masteravinashdubey/2022-BallBot/50_Banti_Pai_Robot-Swarit-updates/Resources/new_assembly (v10~recovered).png

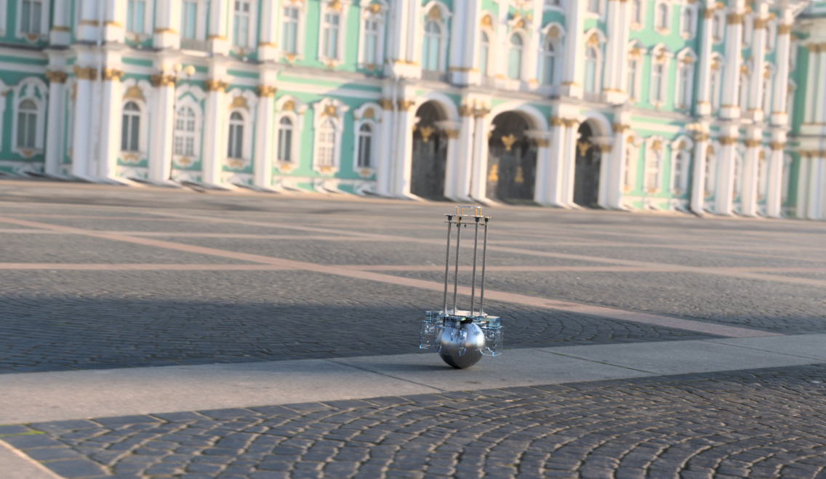
50_Banti_Pai_Robot-Swarit-updates/Resources/new_assembly (v10~recovered).png
