masteravinashdubey/2022-BallBot/README.md

<a href="https://www.youtube.com/watch?v=X55rTUPi5_A&list=PLK0jpMYIBd6BGnQJQYf43Kv_qziwwk5SU&index=11"># 50_Banti_Pai_Robot</a>
