masteravinashdubey/2022-BallBot/50_Banti_Pai_Robot-Swarit-updates/Resources/banti_pai label2.jpg

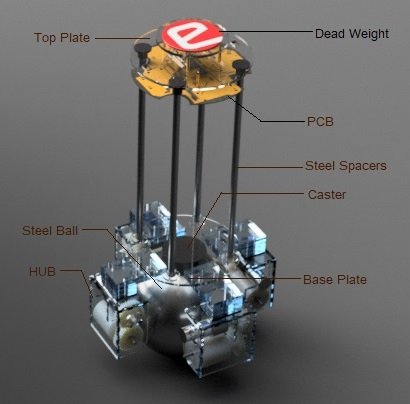
50_Banti_Pai_Robot-Swarit-updates/Resources/banti_pai label2.jpg
