masteravinashdubey/2022-BallBot/50_Banti_Pai_Robot-Swarit-updates/Resources/banti_pai label4.jpg

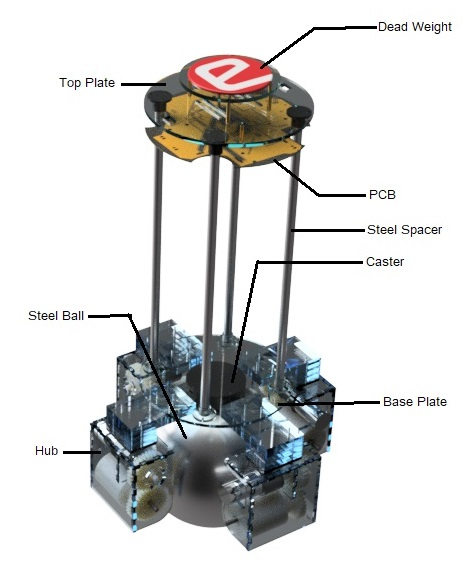
50_Banti_Pai_Robot-Swarit-updates/Resources/banti_pai label4.jpg
