masteravinashdubey/2022-BallBot/50_Banti_Pai_Robot-Swarit-updates/Resources/banti_pai_cad.JPG

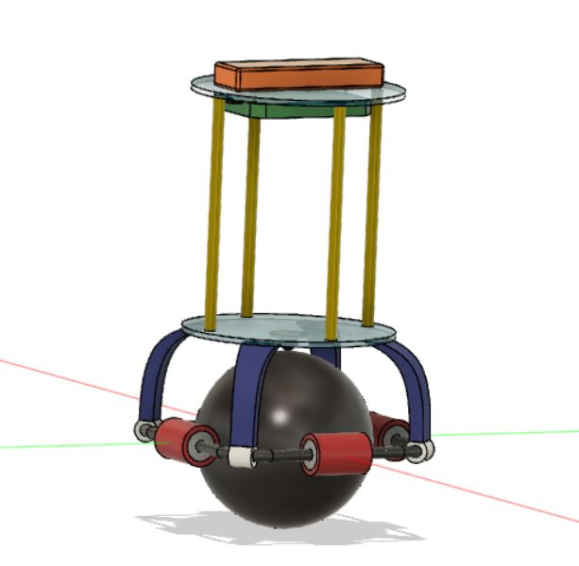
50_Banti_Pai_Robot-Swarit-updates/Resources/banti_pai_cad.JPG
