masteravinashdubey/2022-BallBot/50_Banti_Pai_Robot-Swarit-updates/Resources/Capture.JPG

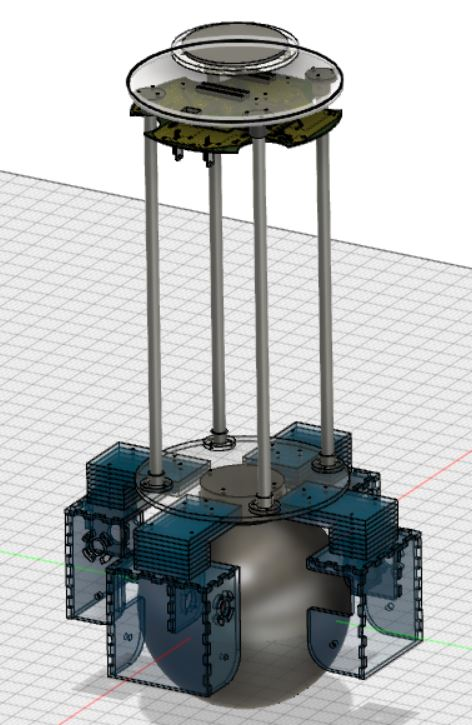
50_Banti_Pai_Robot-Swarit-updates/Resources/Capture.JPG
