masteravinashdubey/2022-BallBot/50_Banti_Pai_Robot-Swarit-updates/Resources/hub2.JPG

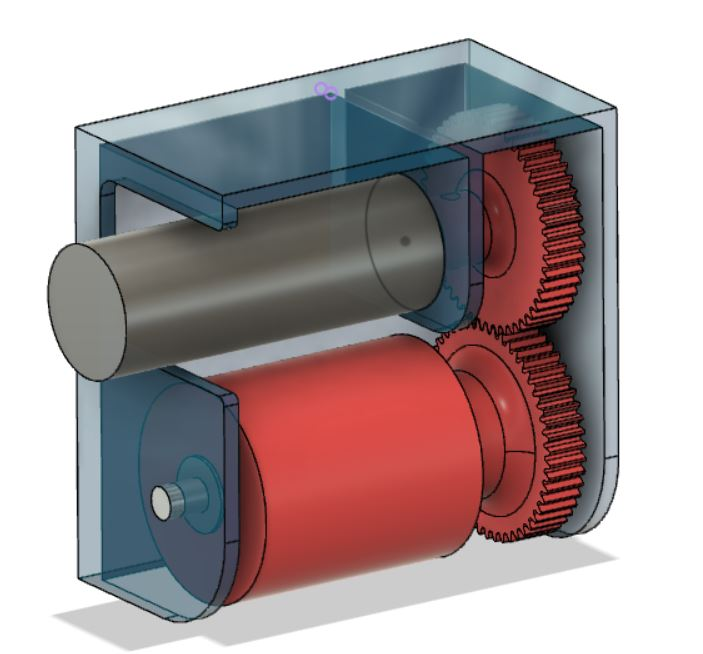
50_Banti_Pai_Robot-Swarit-updates/Resources/hub2.JPG
