masteravinashdubey/2022-BallBot/50_Banti_Pai_Robot-Swarit-updates/Resources/just_bot.png

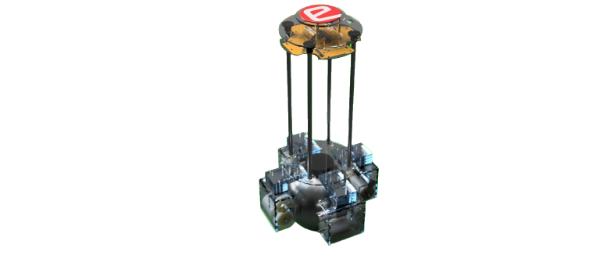
50_Banti_Pai_Robot-Swarit-updates/Resources/just_bot.png
