masteravinashdubey/2022-BallBot/50_Banti_Pai_Robot-Swarit-updates/Resources/render_impro.png

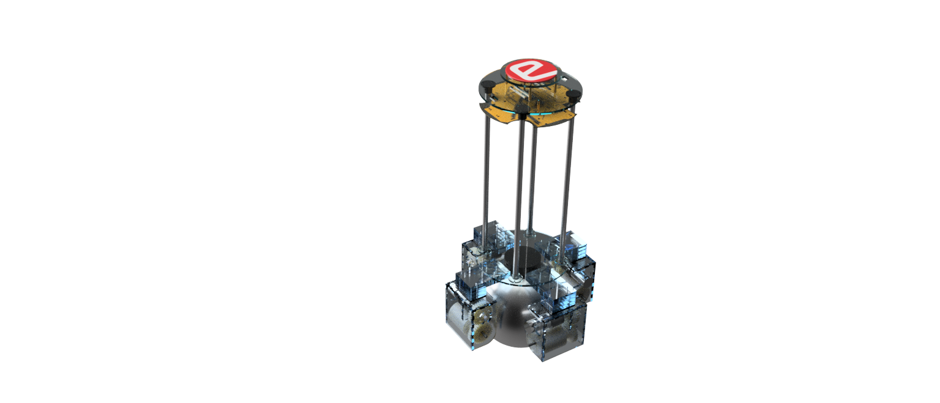
50_Banti_Pai_Robot-Swarit-updates/Resources/render_impro.png
