masteravinashdubey/2022-BallBot/50_Banti_Pai_Robot-Swarit-updates/Resources/components/caster_base.JPG

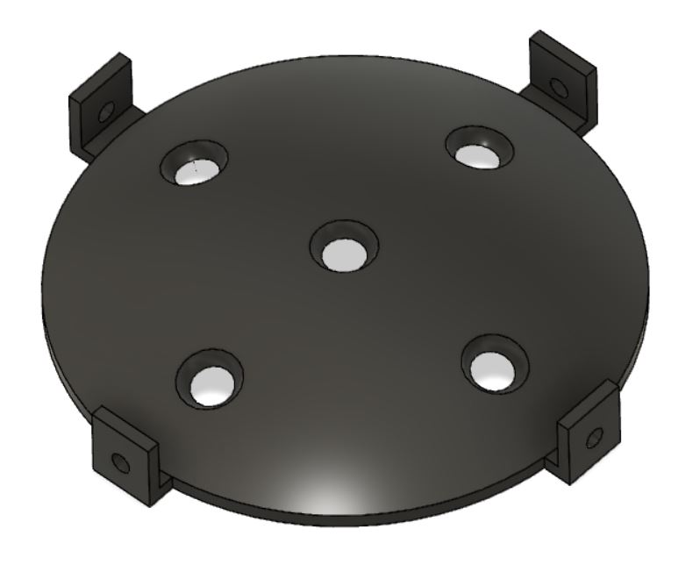
50_Banti_Pai_Robot-Swarit-updates/Resources/components/caster_base.JPG
