masteravinashdubey/2022-BallBot/50_Banti_Pai_Robot-Swarit-updates/Resources/components/caster_top.JPG

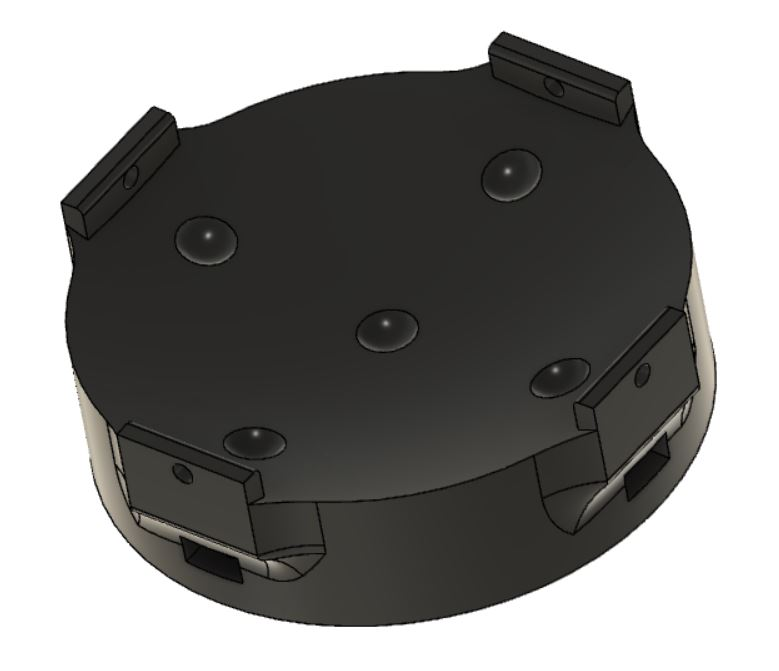
50_Banti_Pai_Robot-Swarit-updates/Resources/components/caster_top.JPG
