masteravinashdubey/2022-BallBot/50_Banti_Pai_Robot-Swarit-updates/Resources/components/flange_holder.JPG

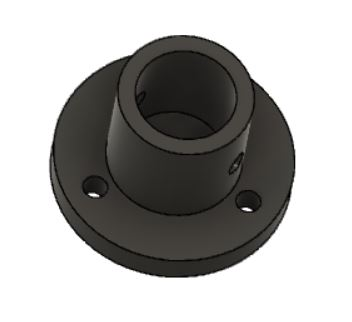
50_Banti_Pai_Robot-Swarit-updates/Resources/components/flange_holder.JPG
