masteravinashdubey/2022-BallBot/50_Banti_Pai_Robot-Swarit-updates/Resources/components/roller.JPG

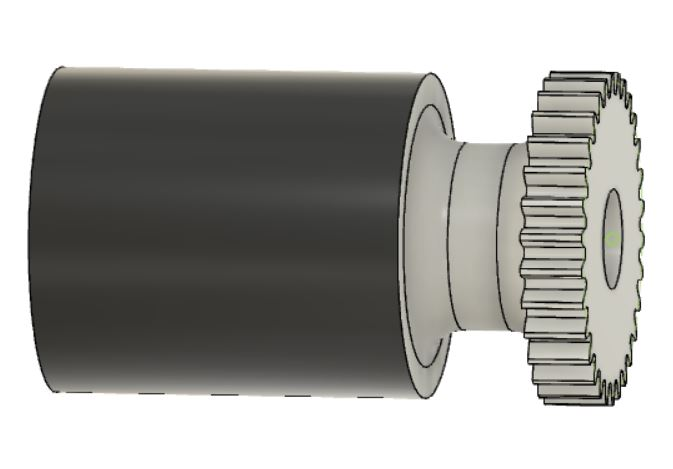
50_Banti_Pai_Robot-Swarit-updates/Resources/components/roller.JPG
