masteravinashdubey/2022-BallBot/50_Banti_Pai_Robot-Swarit-updates/Resources/components/spur_gear.JPG

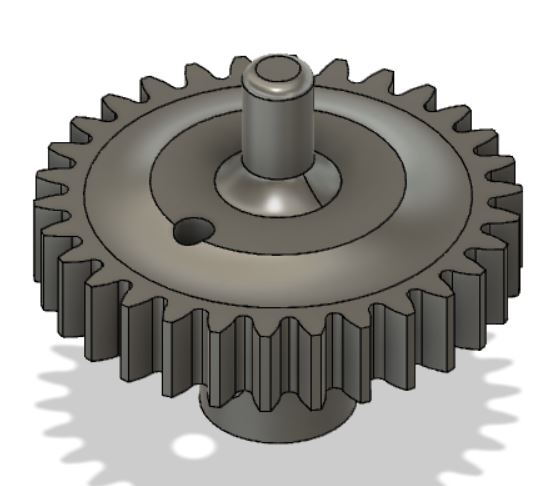
50_Banti_Pai_Robot-Swarit-updates/Resources/components/spur_gear.JPG
