masteravinashdubey/2022-BallBot/50_Banti_Pai_Robot-Swarit-updates/CAD/gcode+stl files/spur_finalllllllll.stl

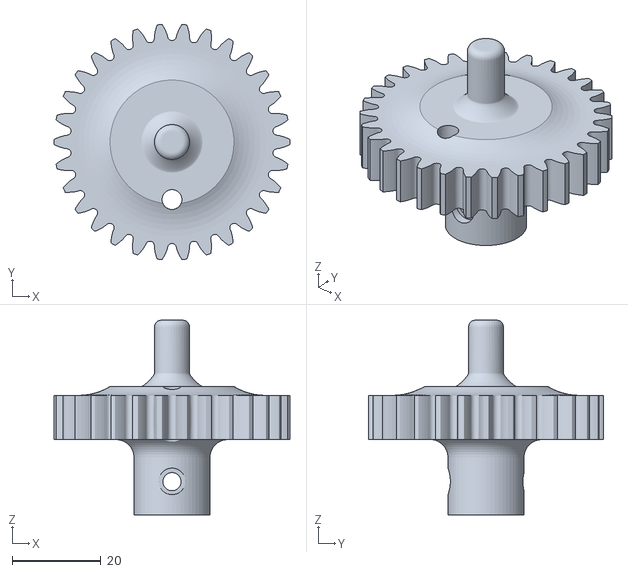
[picture p39: CAD file, 2023-12-04]
50_Banti_Pai_Robot-Swarit-updates/CAD/gcode+stl files/spur_finalllllllll.stl
53.3 x 53.1 x 44.0
