masteravinashdubey/2022-BallBot/50_Banti_Pai_Robot-Swarit-updates/CAD/gcode+stl files/roller_finallllll.stl

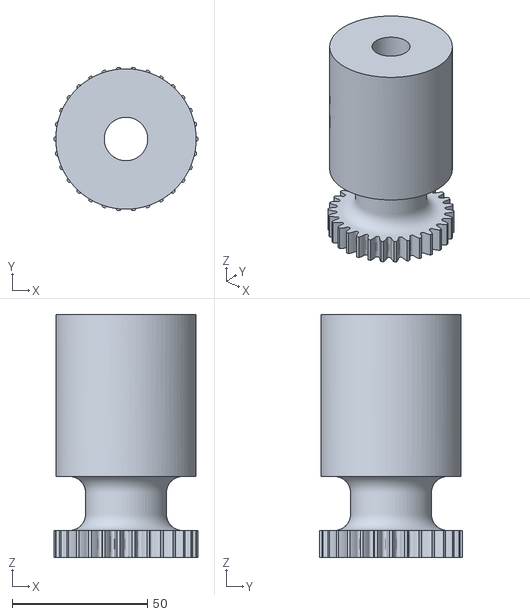
[picture p40: CAD file, 2023-12-04]
50_Banti_Pai_Robot-Swarit-updates/CAD/gcode+stl files/roller_finallllll.stl
53.3 x 53.1 x 90.0
