masteravinashdubey/2022-BallBot/(list of files, cad)

Other CAD files:
50_Banti_Pai_Robot-Swarit-updates/CAD/shaft/shaft.f3d
