masteravinashdubey/2022-BallBot/50_Banti_Pai_Robot-Swarit-updates/CAD/spur_gear_v3 Drawing v1.pdf

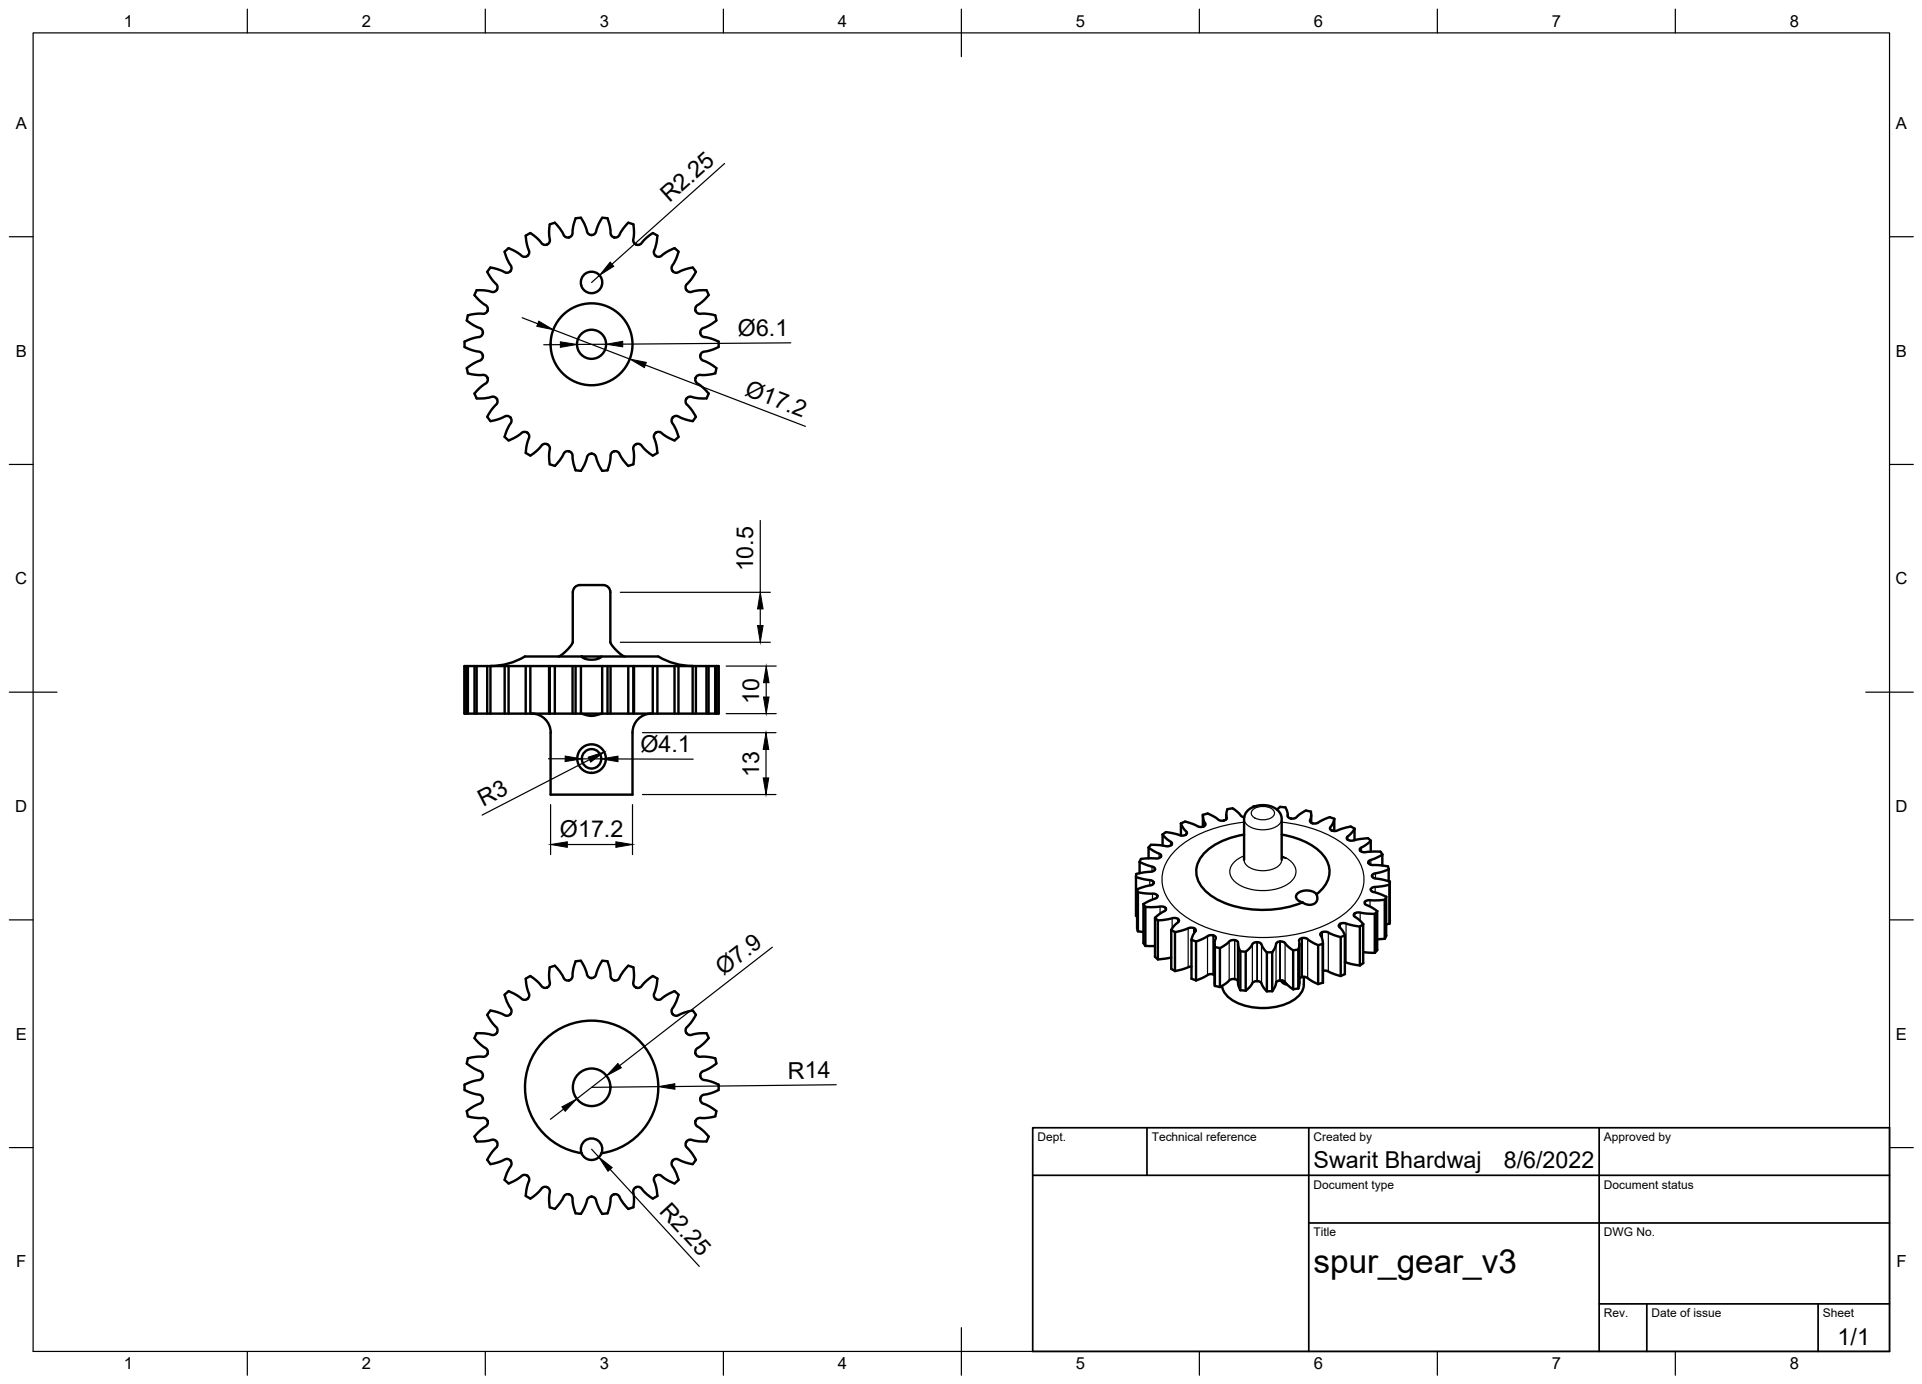
[picture p42: page 1]
Title; DWG No.; Rev.; Date of issue; Sheet; Swarit Bhardwaj 10.5 10

Dept. | Technical reference | Created by 8/6/2022 | Approved by

Document type | Document status
