masteravinashdubey/2022-BallBot/50_Banti_Pai_Robot-Swarit-updates/CAD/shaft/FLANGE_HOLDER Drawing v1.pdf

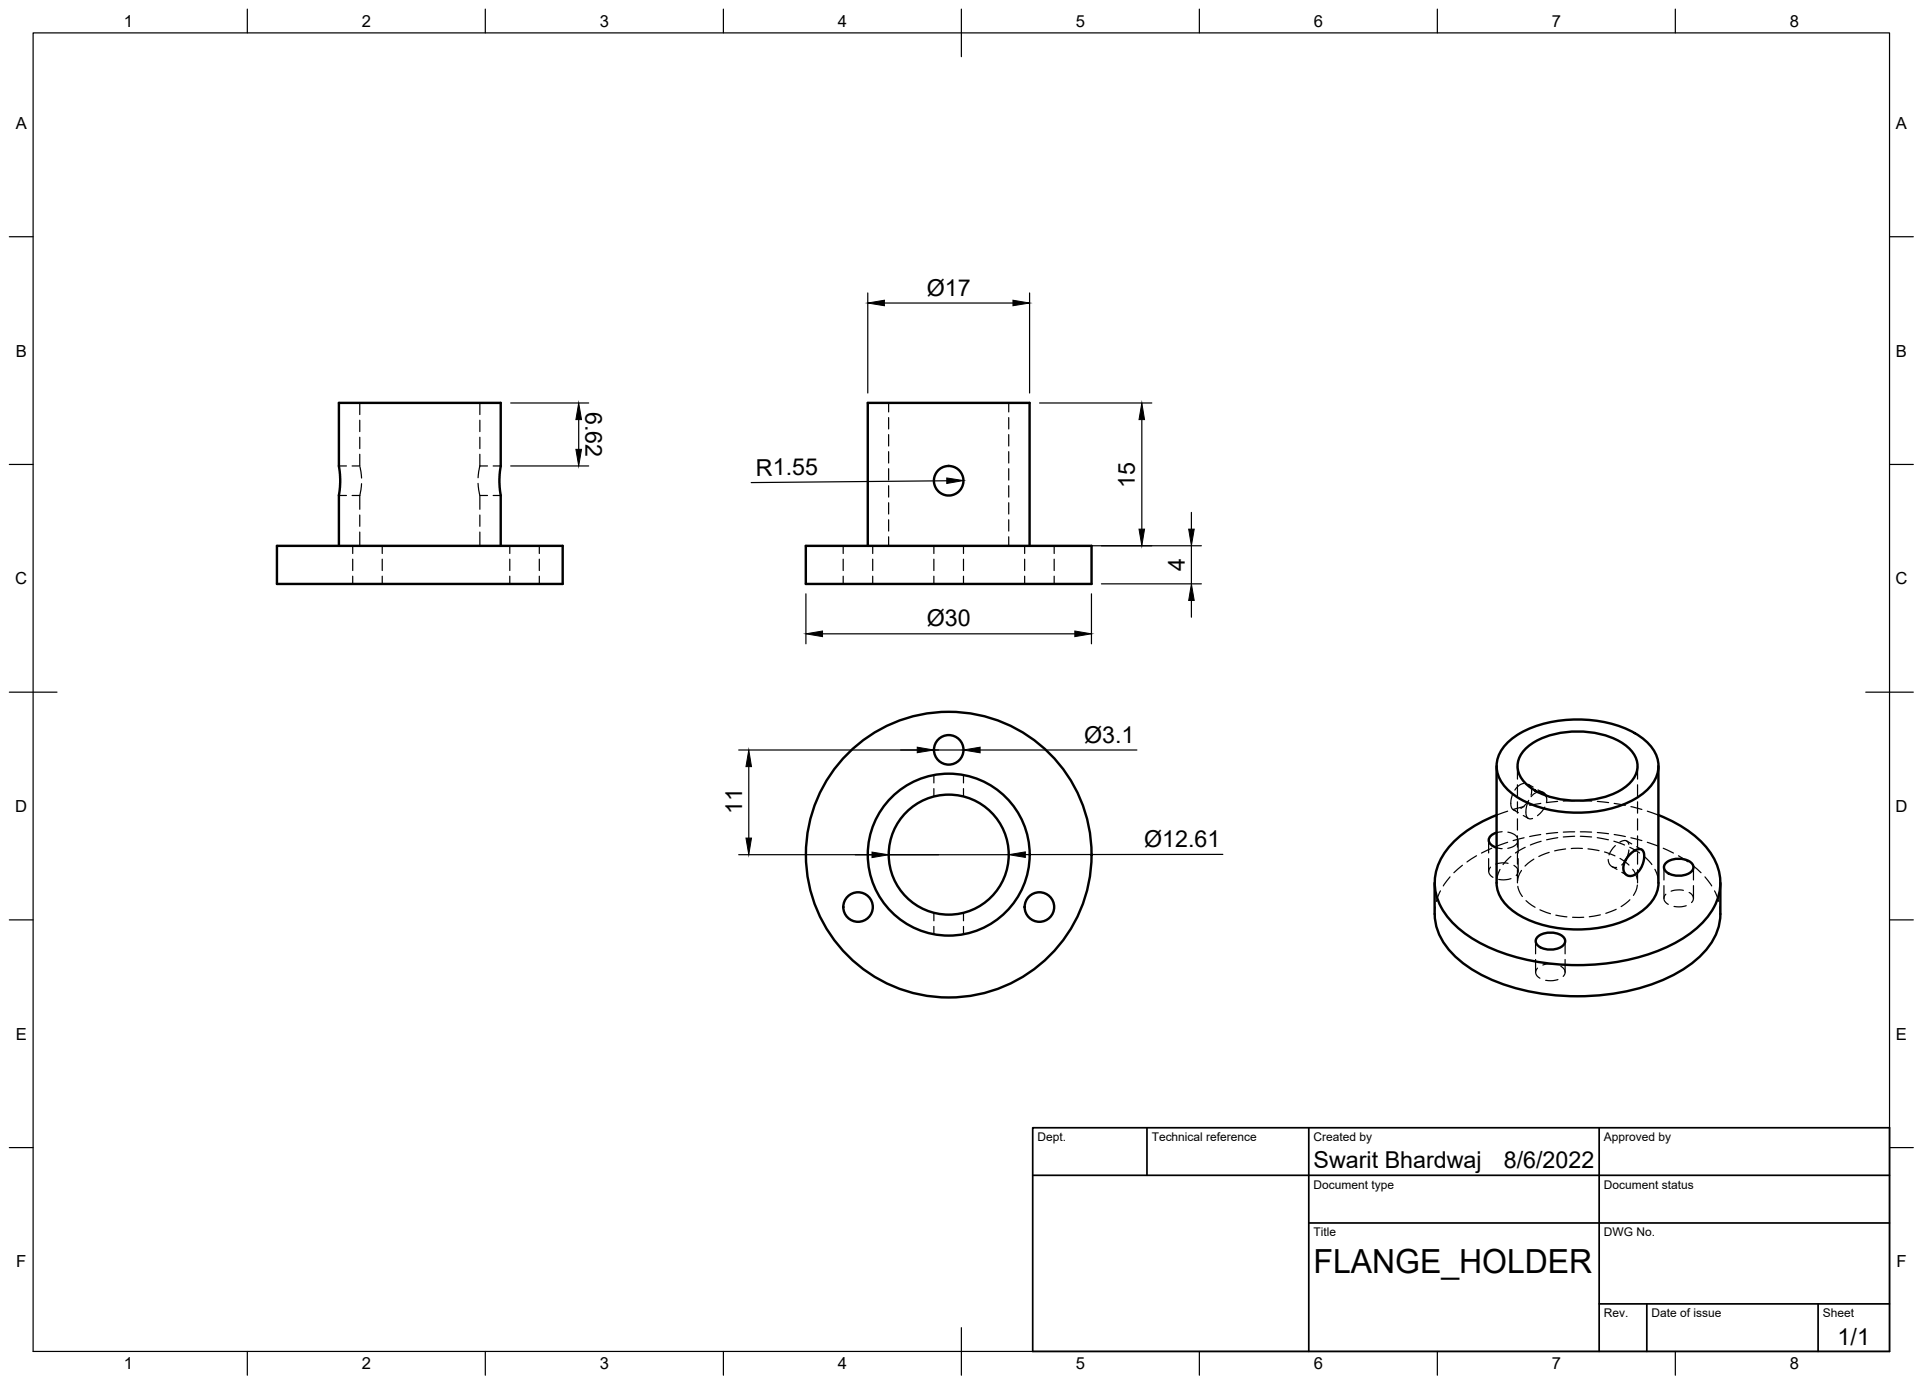
[picture p43: page 1]
Title; DWG No.; Rev.; Date of issue; Sheet

Dept. | Technical reference | Created by Swarit Bhardwaj 8/6/2022 | Approved by

Document type | Document status
