masteravinashdubey/2022-BallBot/50_Banti_Pai_Robot-Swarit-updates/CAD/shaft/shaft_Drawing_v1.pdf

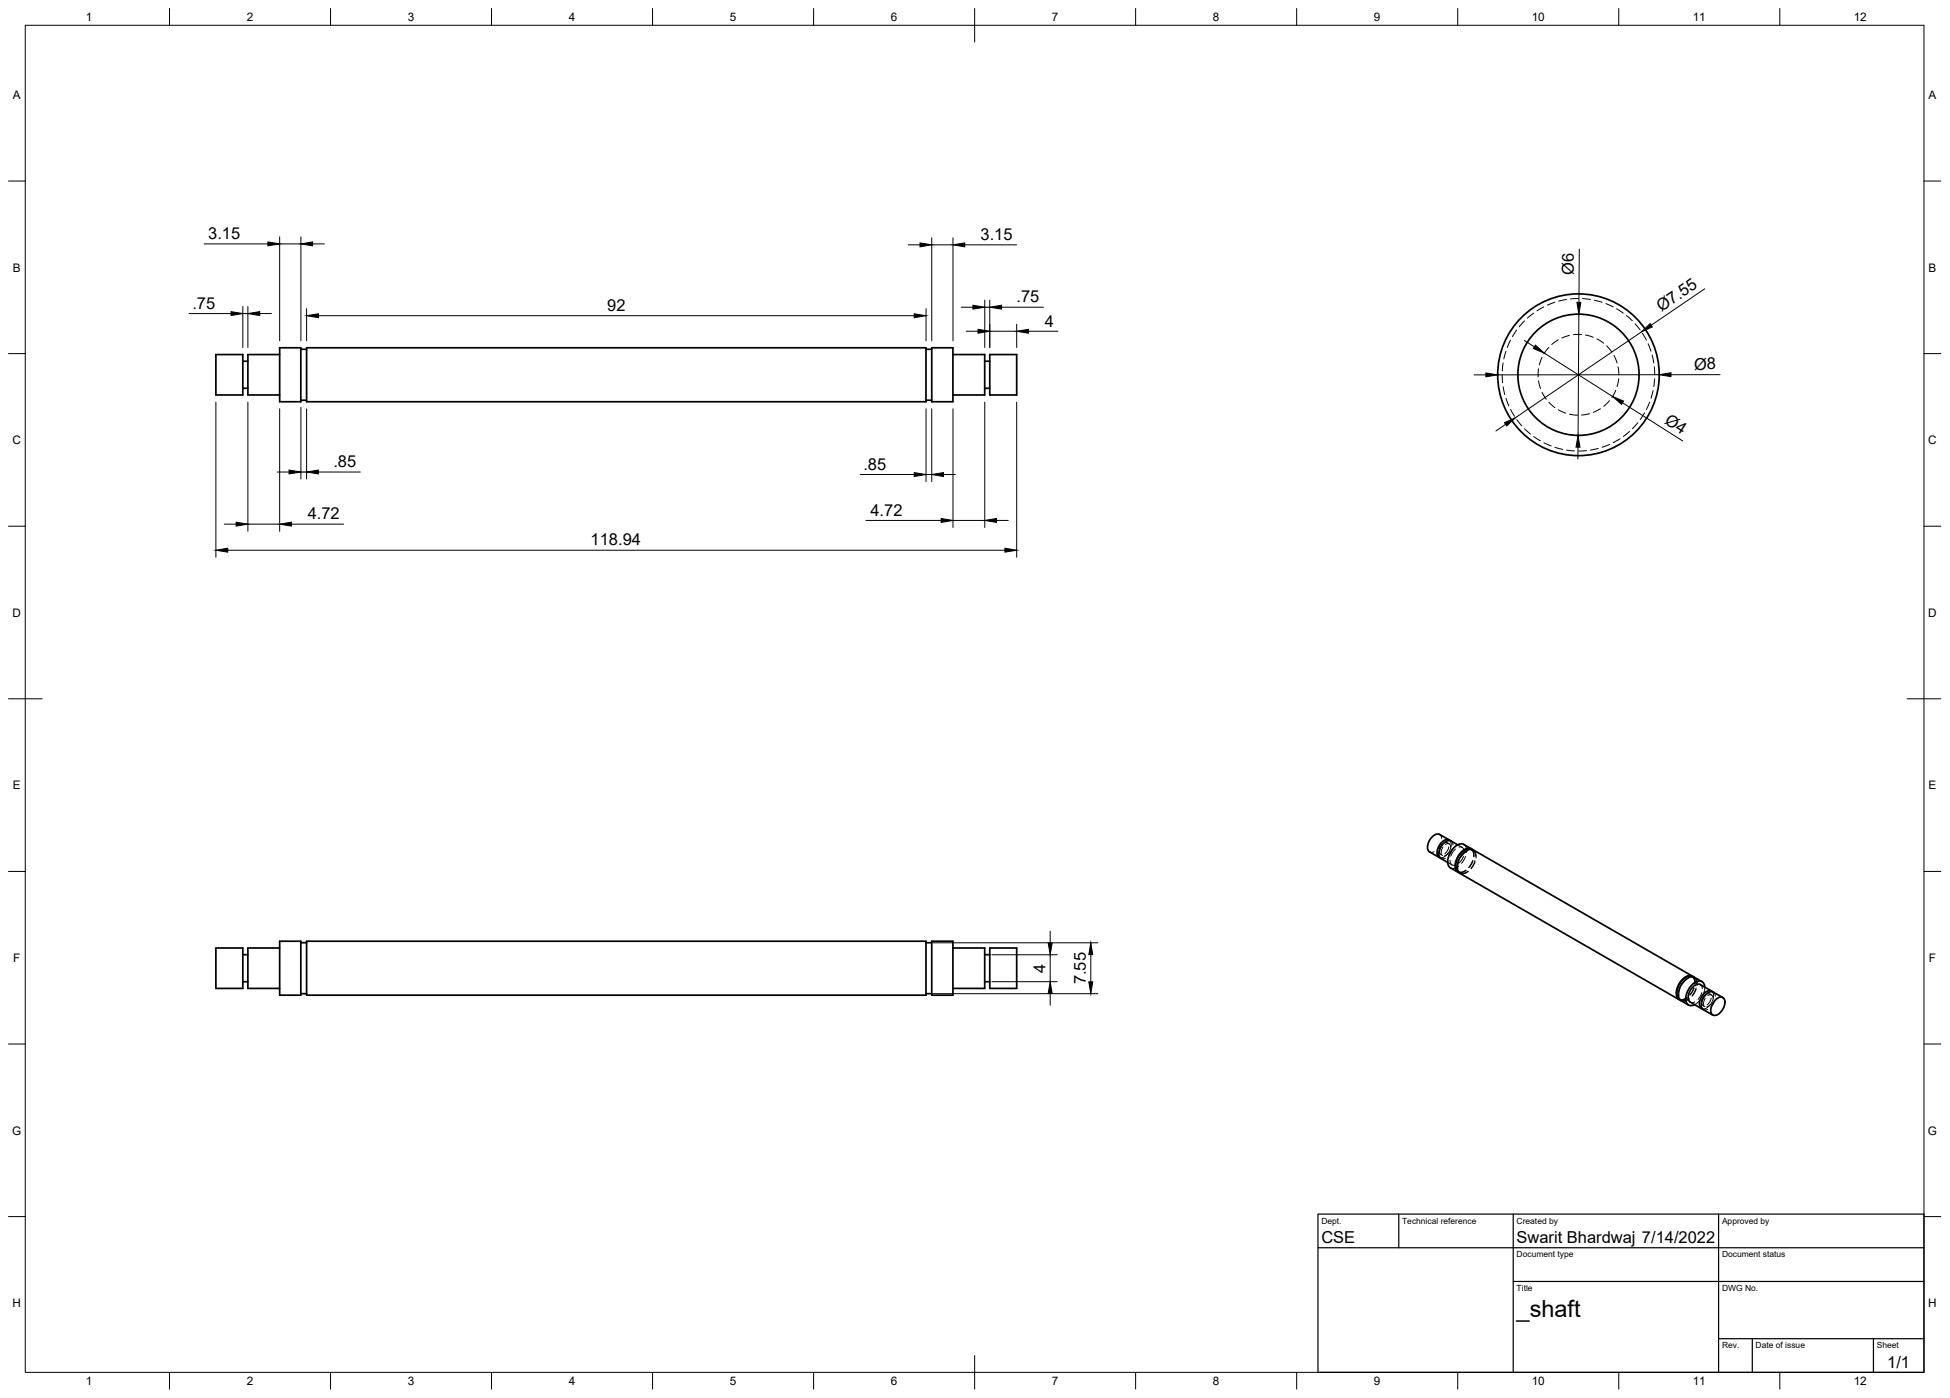
[picture p44: page 1]

Dept. CSE | Technical reference | Created by Swarit Bhardwaj 7/14/2022 | Approved by

Document type | Document status

Title _shaft | DWG No.

Rev. | Date of issue | Sheet 1/1
