masteravinashdubey/2022-BallBot/50_Banti_Pai_Robot-chirag/PCB/Final PCB/BANTI.brd

## EAGLE design 50_Banti_Pai_Robot-chirag/PCB/Final PCB/BANTI.brd (2023-12-04)

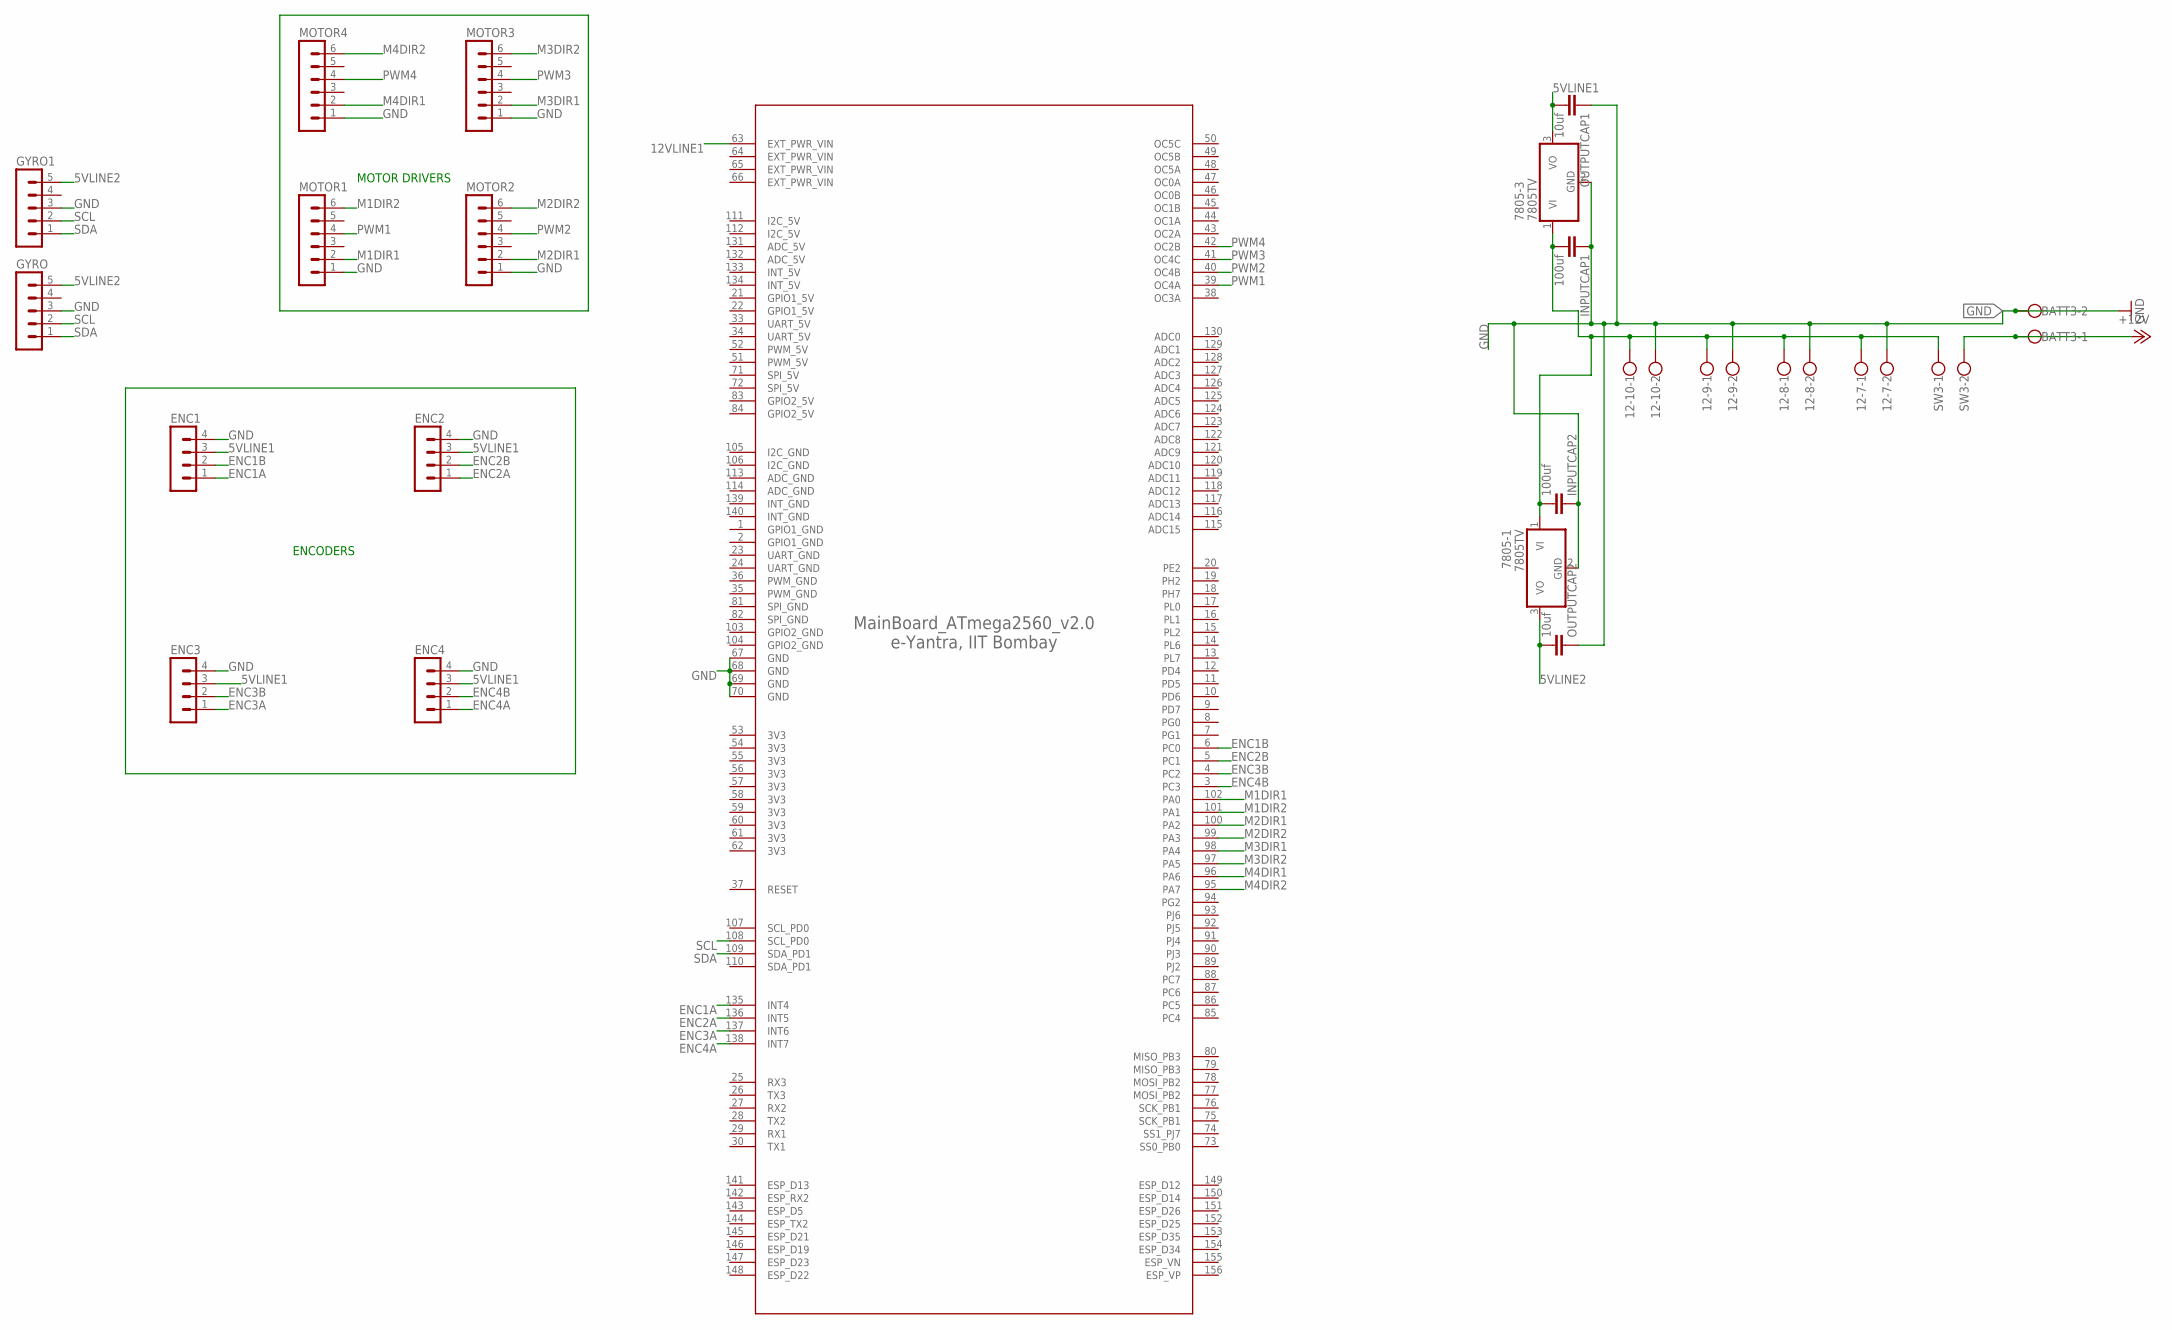
[picture p45: schematic BANTI.sch]

Parts:
12-7, 12-8, 12-9, 12-10: W237-102
7805-1, 7805-3: 7805TV; TO220V
BATT3: W237-102
ENC1, ENC2, ENC3, ENC4: MA04-1
EYFI: ATMEGA2560_V2.0
GYRO, GYRO1: MA05-1
INPUTCAP1, INPUTCAP2: 100uf; C2.5-2
MOTOR1, MOTOR2, MOTOR3, MOTOR4: MA06-1
OUTPUTCAP1, OUTPUTCAP2: 10uf; C2.5-2
SW3: W237-102

Connections:
3V3: EYFI.53 (3V3), EYFI.54 (3V3), EYFI.55 (3V3), EYFI.56 (3V3), EYFI.57 (3V3), EYFI.58 (3V3), EYFI.59 (3V3), EYFI.60 (3V3), EYFI.61 (3V3), EYFI.62 (3V3)
5VLINE1: 7805-3.3 (VO), ENC1.3, ENC2.3, ENC3.3, ENC4.3, OUTPUTCAP1.2
5VLINE2: 7805-1.3 (VO), GYRO.5, GYRO1.5, OUTPUTCAP2.2
12VLINE1: 12-7.1, 12-8.1, 12-9.1, 12-10.1, 7805-1.1 (VI), 7805-3.1 (VI), EYFI.63 (EXT_PWR_VIN), INPUTCAP1.2, INPUTCAP2.2, SW3.1
+12V: BATT3.1, SW3.2
ADC_5V: EYFI.131 (ADC_5V), EYFI.132 (ADC_5V)
ADC_GND: EYFI.113 (ADC_GND), EYFI.114 (ADC_GND)
ENC1A: ENC1.1, EYFI.135 (INT4)
ENC1B: ENC1.2, EYFI.6 (PC0)
ENC2A: ENC2.1, EYFI.136 (INT5)
ENC2B: ENC2.2, EYFI.5 (PC1)
ENC3A: ENC3.1, EYFI.137 (INT6)
ENC3B: ENC3.2, EYFI.4 (PC2)
ENC4A: ENC4.1, EYFI.138 (INT7)
ENC4B: ENC4.2, EYFI.3 (PC3)
EXT_PWR_VIN: EYFI.64 (EXT_PWR_VIN), EYFI.65 (EXT_PWR_VIN), EYFI.66 (EXT_PWR_VIN)
GND: 12-7.2, 12-8.2, 12-9.2, 12-10.2, 7805-1.2 (GND), 7805-3.2 (GND), BATT3.2, ENC1.4, ENC2.4, ENC3.4, ENC4.4, EYFI.67 (GND), EYFI.68 (GND), EYFI.69 (GND), EYFI.70 (GND), GYRO.3, GYRO1.3, INPUTCAP1.1, INPUTCAP2.1, MOTOR1.1, MOTOR2.1, MOTOR3.1, MOTOR4.1, OUTPUTCAP1.1, OUTPUTCAP2.1
GPIO1_5V: EYFI.21 (GPIO1_5V), EYFI.22 (GPIO1_5V)
GPIO1_GND: EYFI.1 (GPIO1_GND), EYFI.2 (GPIO1_GND)
GPIO2_5V: EYFI.83 (GPIO2_5V), EYFI.84 (GPIO2_5V)
GPIO2_GND: EYFI.103 (GPIO2_GND), EYFI.104 (GPIO2_GND)
I2C_5V: EYFI.111 (I2C_5V), EYFI.112 (I2C_5V)
I2C_GND: EYFI.105 (I2C_GND), EYFI.106 (I2C_GND)
INT_5V: EYFI.133 (INT_5V), EYFI.134 (INT_5V)
INT_GND: EYFI.139 (INT_GND), EYFI.140 (INT_GND)
M1DIR1: EYFI.102 (PA0), MOTOR1.2
M1DIR2: EYFI.101 (PA1), MOTOR1.6
M2DIR1: EYFI.100 (PA2), MOTOR2.2
M2DIR2: EYFI.99 (PA3), MOTOR2.6
M3DIR1: EYFI.98 (PA4), MOTOR3.2
M3DIR2: EYFI.97 (PA5), MOTOR3.6
M4DIR1: EYFI.96 (PA6), MOTOR4.2
M4DIR2: EYFI.95 (PA7), MOTOR4.6
PWM1: EYFI.39 (OC4A), MOTOR1.4
PWM2: EYFI.40 (OC4B), MOTOR2.4
PWM3: EYFI.41 (OC4C), MOTOR3.4
PWM4: EYFI.42 (OC2B), MOTOR4.4
PWM_5V: EYFI.51 (PWM_5V), EYFI.52 (PWM_5V)
PWM_GND: EYFI.35 (PWM_GND), EYFI.36 (PWM_GND)
SCL: EYFI.108 (SCL_PD0), GYRO.2, GYRO1.2
SDA: EYFI.109 (SDA_PD1), GYRO.1, GYRO1.1
SPI_5V: EYFI.71 (SPI_5V), EYFI.72 (SPI_5V)
SPI_GND: EYFI.81 (SPI_GND), EYFI.82 (SPI_GND)
UART_5V: EYFI.33 (UART_5V), EYFI.34 (UART_5V)
UART_GND: EYFI.23 (UART_GND), EYFI.24 (UART_GND)

Notes on the sheet:
ENCODERS
MOTOR DRIVERS

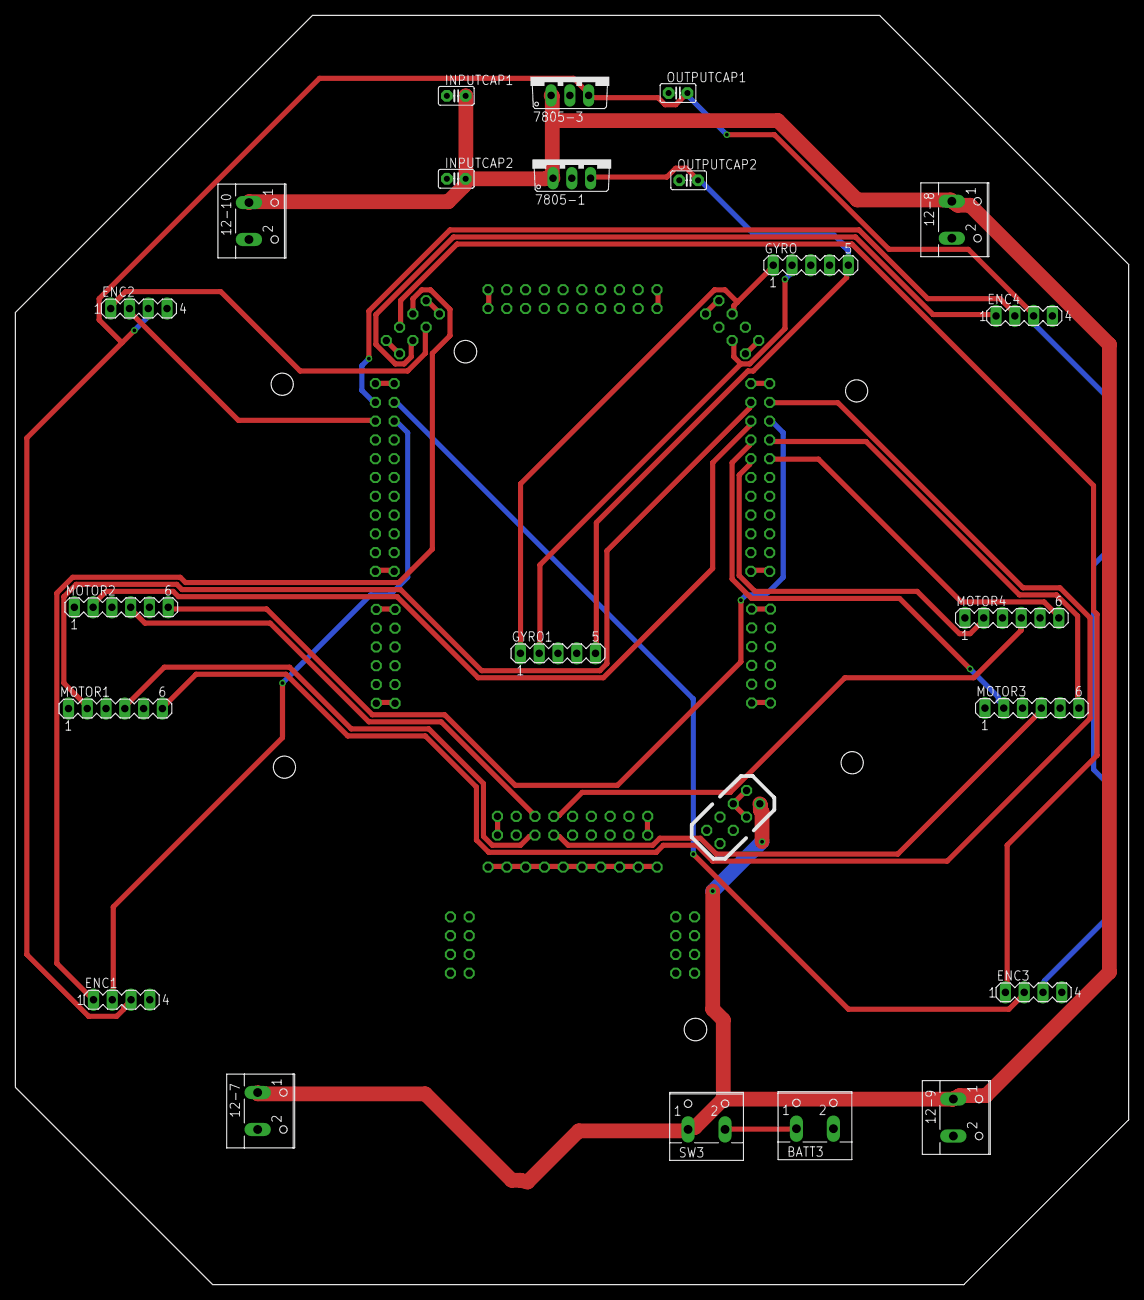
[picture p46: board BANTI.brd from above]

Board: 2 copper layers, 150.6 x 171.7 mm, 23 parts (0 on the bottom side), 45 nets.
