masteravinashdubey/2022-BallBot/(commit log)

2023-12-04 Swarit Files
    [roller_finallllll.stl, shaft.f3d, spur_finalllllllll.stl]
2023-12-04 chirag files
    [BANTI.GBL, BANTI.GBO, BANTI.GBP, BANTI.GBS, BANTI.GKO, BANTI.GTL, BANTI.GTO, BANTI.GTP]
